jasonmarkham/FWS_V3.2/README.md

# FWS_V3.2
3D Printer Filament Width Sensor
